W-Floyd/speakeasy/pcb/speakeasy/opti-panel/report.html

# Speakeasy PCB Cost Report

PCB size41.0 × 41.0 mm

AssemblyStandard

Extended parts5

Import duty35.0%

Sales tax9.4%

ShippingDHL Express (DDP)

GeneratedJune 05, 2026

## Summary

Best Price / Board

$13.38 ($14.27)

25 panels × 3x3 · COGS (sale)

Best PCBA Merch Cost / Board

$9.39

25 panels × 3x3

Dominant Cost Bucket

Components

25 panels × 3x3

## COGS per Board — sale price in parens ($/board)

Panels | 1x1 | 2x2 | 2x3 | 3x3
5 | ~$37.12(~$39.05) | $19.20($20.29)✓ | ~$17.43(~$18.41) | $15.89($16.84)✓
10 | $27.27($28.83)✓ | $15.43($16.33)✓ | ~$15.26(~$16.18) | $14.41($15.31)✓
15 | ~$25.43(~$26.87) | ~$15.14(~$16.05) | ~$14.31(~$15.22) | ~$13.99(~$14.88)
20 | ~$23.42(~$24.81) | $14.54($15.45)✓ | ~$14.09(~$14.98) | ~$13.61(~$14.50)
25 | ~$22.22(~$23.57) | ~$14.02(~$14.91) | ~$13.76(~$14.64) | ~$13.38(~$14.27)

Green = lowest COGS in row | White ✓ = verified JLCPCB quote | Grey ~ = model estimate | (parens) = sale price incl. sales tax

## Sale Price per Board vs Panels Ordered

Quantity: Affects breakdown charts and BOM table below

## Cost Breakdown per Board (Stacked)

## Component Cost Breakdown (BOM Pie)

Variant:

## Bill of Materials

LCSC | Description | Qty/bd | Lib Type | Unit Price | $/board
C19702 | 10uF | 1 | Basic | $0.0138 | $0.0230
C15525 | 10uF | 1 | Basic | $0.0175 | $0.0292
C1525 | 100nF | 2 | Basic | $0.0017 | $0.0045
C52923 | 1uF | 1 | Basic | $0.0053 | $0.0088
C64659 | PH-6P立贴 | 1 | Extended | $0.0962 | $0.0962
C20608465 | 210-A-SMD/02 | 1 | Extended | $1.1920 | $1.1920
C25905 | 5.1k | 2 | Basic | $0.0009 | $0.0024
C25744 | 10k | 1 | Basic | $0.0013 | $0.0022
C11702 | 1k | 1 | Basic | $0.0011 | $0.0018
C25741 | 100k | 1 | Basic | $0.0009 | $0.0015
C720477 | BOOT | 2 | Basic | $0.0563 | $0.1276
C22356044 | ESP32-S3-MINI-1U-N4R2 ⚠ Std Only | 1 | Extended | $4.1114 | $4.1114
C910544 | MAX98357AETE+T | 1 | Extended | $1.1630 | $1.1630
C6909495 | MPM3810GQB-33-Z | 1 | Extended | $1.8298 | $1.8298
Components / board | | | | | $8.5934

Extended parts incur an extra fee per order | ⚠ Std Only forces Standard PCBA type

PCBA Merch Cost per Board (excl. duty / shipping)

Panels | 1x1 | 2x2 | 2x3 | 3x3
5 | ~$20.53 | $11.64✓ | ~$10.50 | $10.15✓
10 | $16.68✓ | $9.62✓ | ~$9.83 | $9.67✓
15 | ~$15.39 | ~$9.74 | ~$9.60 | ~$9.51
20 | ~$14.75 | $9.65✓ | ~$9.49 | ~$9.43
25 | ~$14.37 | ~$9.48 | ~$9.42 | ~$9.39

Bare PCBA price from JLCPCB. ~ = estimated from model.

PCB Bare Board Cost per Board (no assembly)

Panels | 1x1 | 2x2 | 2x3 | 3x3
5 | ~$0.97 | ~$0.37 | $0.30✓ | $0.26✓
10 | ~$0.57 | ~$0.27 | ~$0.24 | ~$0.21
15 | ~$0.44 | ~$0.24 | ~$0.21 | ~$0.20
20 | ~$0.37 | ~$0.22 | ~$0.20 | ~$0.19
25 | ~$0.33 | ~$0.21 | ~$0.20 | ~$0.19

Engineering fee $4.00 + $0.1694/board-in-panel × boards × panels. ~ = estimated from model.
