W-Floyd/speakeasy/pcb/speakeasy/speakeasy/jlcpcb/speakeasy_lowcost_jlcpcb_bom.csv

Comment | Designator | Footprint | LCSC Part #
 | U1 | Project:ESP32-S3_SUPER_MINI
