W-Floyd/speakeasy/pcb/speakeasy/speakeasy_lowcost/jlcpcb/speakeasy_lowcost_jlcpcb_bom.csv

Comment | Designator | Footprint | LCSC Part #
 | U1 | Project:ESP32_S3_SUPER_MINI_MODULE
 | U2 | Project:adafruit-MAX98357
