W-Floyd/speakeasy/(list of files, drawings)

Other design files:
snapclient-kconfig/sdkconfig.pcb
