W-Floyd/speakeasy/(commit log)

2026-05-29 fix for bad boards
2026-05-29 Refactor firmware configs into composable packages
    Extract audio and improv config into common/ packages so each
    top-level YAML only declares substitutions and includes; device
    names shortened to remove the redundant 'speakeasy-' prefix.
    [sendspin-audio.yaml]
2026-05-29 Add no-Bluetooth variants for all firmware configs
    Bluetooth disabled variants free up significant heap/IRAM on
    devices where BT is unused.
2026-05-29 Add config generator and pre-commit hook; flatten all variant YAMLs
    cmd/gen-configs generates all 24 speakeasy-*.yaml files from a single
    variant matrix (proto × 2ch × mdns × nobt × ipv6). .githooks/pre-commit
    runs the generator and stages results on every commit.
    Run `git config core.hooksPath .githooks` after cloning to activate.
2026-05-29 Web installer: replace variant list with config selection wizard
    Five questions (protocol, Snapcast server mode, BT, IPv6, output)
    build the manifest path dynamically. Snapcast server question is
    hidden for Sendspin. Shows the variant name and a single Flash
    button; flags unavailable combinations (e.g. 2ch not pre-built).
2026-05-29 Extract WiFi power/ramp into packages; add 4 wifi variants
    base.yaml loses all TX power and ramp config. Four new packages:
    wifi-85.yaml — 8.5 dBm fixed
    wifi-ramp.yaml — stock power + user control + ramp (cap 20.5)
    wifi-85ramp.yaml — 8.5 dBm + user control + ramp (cap 8.5)
    (no package) — stock power, static (new default, no suffix)
    [wifi-ramp.yaml]
2026-05-29 CI/index/wizard: add WiFi dimension (wstock/w85/wramp/w85ramp)
    48 active builds (12 base variants × 4 wifi modes). Web wizard
    gains a WiFi TX Power question with 4 pill options.
2026-05-29 Add variants.yaml as build source of truth
    variants.yaml declares only which variants CI builds (currently 2).
    cmd/gen-ci regenerates .github/workflows/build.yaml from it on commit.
    Docker builds all speakeasy-*.yaml via glob — no list to maintain.
    Dockerfile no longer needs variants.yaml or build.yaml.
2026-05-29 Shorten proto names: sendspin→ss, snapcast→sc
    Keeps hostnames within ESPHome's 24-char limit.
    Labels in the web wizard remain "Sendspin" / "Snapcast".
2026-05-29 Shorten suffixes: -ipv6→-6, w85→w9/w9r, wramp→wr; invert BT to -bt; 9dBm
    Max hostname now 20 chars (well under ESPHome's 24-char limit).
    wifi-85/wifi-85ramp packages replaced by wifi-9/wifi-9ramp at 9.0 dBm.
2026-05-29 Fix duplicate wifi: key in wifi-9ramp.yaml; remove obsolete wifi-85 packages
    [wifi-9ramp.yaml]
2026-05-29 gen-ci: generate Dockerfile with parallel firmware stages
    Each speakeasy-*.yaml gets its own FROM stage with an isolated
    .esphome cache (id=<variant>) and a shared locked PlatformIO cache.
    BuildKit runs all 48 stages in parallel. A collect stage merges
    outputs before the web/server stages.
2026-05-29 Dockerfile: prime PlatformIO in first stage, all others inherit it
    First firmware stage (firmware-sc-6-w9) builds from base, downloading
    the ESP-IDF toolchain into the image layer. All 47 remaining stages
    use FROM firmware-sc-6-w9 so the toolchain is already present with no
    contention. Only the ESPHome build cache stays per-stage.
2026-05-29 Dockerfile: sequential chain, per-stage .esphome cache
    Stages build one after another so ~/.platformio accumulates through
    image layers without re-downloading. Each stage keeps its own
    .esphome cache mount to avoid bloating layers. Collect copies only
    from the final stage which holds all accumulated outputs.
2026-05-29 Isolate toolchain priming from variant yaml changes
    primer.yaml + common/ live in the base stage before speakeasy-*.yaml
    is copied, so changing variant configs doesn't invalidate the primed
    toolchain layer. Cache invalidation chain:
    base (tools+common+primer) → primed (toolchain) → variants (yamls) → builds
2026-05-29 Reorder Dockerfile stages by component set to maximise ccache hits
    gen-configs --dry-run emits filenames in generation order; gen-ci reads
    that instead of globbing so the Dockerfile chain matches. WiFi mode is
    outermost, BT second: all wstock/no-bt compile first, then wstock/bt
    (BLE stack warm), then w9, wr, w9r groups. Ramp lambdas and BLE stack
    each compile once and are reused by all subsequent variants in that group.
2026-05-30 Update default I2S pins: GPIO6/5/4 → GPIO8/9/10
2026-05-30 base: set enable_high_performance: false
    Recommended by snapclient PR #14389 for WiFi devices — helps maintain
    playback after WiFi glitches.
2026-05-31 Generate esp32 variant at top level of each config
    Ensures variant: esp32s3 is set even if common/base.yaml package
    resolution fails during ESPHome dashboard compilation.
2026-06-01 Revert "meh"
    This reverts commit 6076602b22e367b01dca4988bd9ac845172b2725.
    [Speakeasy.kicad_sch, skidl_REPL.kicad_sch]
2026-06-01 1ch again
    [Speakeasy.kicad_sch, speakeasy_jlcpcb_bom.csv]
2026-06-01 panelize variants
    [Speakeasy_panel_2x2-B_Courtyard.gbr, Speakeasy_panel_2x2-B_Cu.gbl, Speakeasy_panel_2x2-B_Mask.gbs, Speakeasy_panel_2x2-B_Paste.gbp, Speakeasy_panel_2x2-B_Silkscreen.gbo, Speakeasy_panel_2x2-Edge_Cuts.gm1, Speakeasy_panel_2x2-F_Courtyard.gbr, Speakeasy_panel_2x2-F_Cu.gtl]
2026-06-05 Add standalone snapclient builds and clean up variant naming
    - Add CarlosDerSeher/snapclient as a git submodule
    - Add cmd/gen-snapclient to generate kconfig defaults for standalone builds
    - Generate snapclient-kconfig/sdkconfig.{mdns,mdns-w9} for ESP32-S3 + MAX98357A
    - Update Dockerfile and CI to build standalone snapclient via espressif/idf:v5.5.1,
    producing a merged binary and manifest.json for esp-web-tools flashing
    - Add standalone snapclient as a protocol choice in the web flash page
    - Remove manual IP snapcast variants (all builds now use mDNS)
    - Drop 'mdns' from variant names since all variants use mDNS
    - Update README: correct DAC (MAX98357A), GPIO pins, and hardware description
    -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
2026-06-05 Add pin mapping table to web flash page
2026-06-05 Register pcb/circuit-synth-local as a submodule
2026-06-05 Track dev branch for circuit-synth-local submodule
2026-06-05 Use HTTPS for circuit-synth-local submodule for CI access
2026-06-05 Only recurse into snapclient submodule in CI
    circuit-synth-local has a broken nested submodule; init it shallowly
    and recurse only into snapclient explicitly.
2026-06-05 Skip circuit-synth-local submodule in CI, init only snapclient
2026-06-05 Fix Stage firmware step to use bash shell
2026-06-05 Improve WiFi TX power UI for standalone snapclient
    - Remove "Sendspin" from timing failure description
    - Hide ramp options when standalone snapclient is selected
    - Drop "no HA control" from 9 dBm label
2026-06-05 Disable light sleep for snapclient to fix Improv USB Serial JTAG
    Light sleep gates USB clocks on ESP32-S3, breaking the USB Serial JTAG
    interface used by Improv WiFi provisioning.
2026-06-05 Enable soft volume control for standalone snapclient
    MAX98357A has no hardware volume register, so Snapcast volume commands
    had no effect. Enable CONFIG_USE_DSP_PROCESSOR and
    CONFIG_SNAPCLIENT_USE_SOFT_VOL so the DSP processor scales PCM samples
    before I2S output.
2026-06-05 Remove ccache mounts from standalone snapclient builds
2026-06-05 Update snapclient: native TX power control; drop mdns-w9 variant
    TX power is now configurable via the general settings web UI (8.5–20 dBm),
    applied at boot and live on change, persisted to NVS — replacing the
    separate kconfig-based mdns-w9 build variant.
    Also syncs sdkconfig.mdns with the Sendspin kconfig baseline: adds missing
    SPIRAM init/malloc opts, WiFi TX buffer settings, compiler perf opt,
    FreeRTOS IRAM/tick opts, WiFi IRAM opts (beneficial on quad PSRAM S3),
    AMPDU windows, disconnected PM disable, LwIP tuning, and log level opts.
2026-06-06 Update snapclient: track develop branch; overlay cleanup; enable TX power + vol curve
    - Submodule now tracks W-Floyd/snapclient develop branch
    - sdkconfig overlay restructured: removes upstream duplicates, comments out
    non-essential tuning for incremental validation
    - Enables CONFIG_SNAPCLIENT_WIFI_TX_POWER_CONTROL (native to develop branch)
    - Sets CONFIG_SNAPCLIENT_VOLUME_CURVE_DB_RANGE=40 (was 60)
2026-06-07 Remove WiFi TX power axis; add snapclient OTA binary to builds and index
    ESPHome variants now always include common/wifi-ramp.yaml (stock power +
    HA ramp control on drop), eliminating the w9/wr/w9r axis. Reduces variant
    count from 16 to 4 (ss, sc, ss-bt, sc-bt).
    Snapclient builds now produce a snapclient-<variant>-ota.bin alongside
    merged.bin, included in Docker, CI artifacts, and the web installer as a
    download link. Index page details the web OTA feature in the changes section.
    Also adds scripts/ota-flash-snapclient.sh for extracting from the Docker
    image and flashing over the network, with pre/post SHA256 verification via
    /api/ota/status and TCP port 8032 fallback for old firmware.
    Co-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
2026-06-08 snapclient: update submodule to aa127dd; enable DSP soft clip
    Submodule changes:
    - Fix WiFi TX power unit labels (raw ESP-IDF units, not dBm)
    - Apply channel mode immediately without restart
    - Rate-limit RESYNCING HARD log spam to once per second
    - Remove udp_logger integration (keep component files)
    sdkconfig changes (gen-snapclient and sdkconfig.mdns):
    - Enable CONFIG_USE_DSP_SOFT_CLIP
2026-06-08 snapclient: update submodule to 4859f59
    - Add Mono channel mode (mix L+R to both outputs)
    - Add manifest-based pull OTA: device fetches manifest URL, version-checks,
    downloads and flashes binary with SHA-256 integrity verification
    - Fix pull OTA: HTTPS TLS verification, manifest URL encoding (POST+JSON),
    body_len redefinition, httpd stack overflow, app_desc offset (40→48)
    - Add MBEDTLS_CERTIFICATE_BUNDLE dependency for HTTPS OTA
2026-06-08 index: update changelog; show OTA manifest URL for pull OTA
    - Channel routing: add Mono to the description
    - Split Web OTA into push and pull entries
    - Show pull OTA manifest URL below the flash area when available,
    with a note that already-flashed devices can use it directly
    - gen-index: scan for ota-manifest.json per variant and expose to JS
2026-06-08 index: make OTA manifest URL copy-pasteable
    Replace <code> with a read-only input + Copy button that writes to
    clipboard and briefly shows "Copied!" confirmation.
2026-06-08 snapclient: extract app_elf_sha256 from binary for OTA manifest
    The manifest sha256 field now matches what the device reports via
    esp_app_desc_t.app_elf_sha256 (scanned by magic word 0xABCD5432,
    read at struct offset +144). Adds file_sha256 for the full-file hash.
2026-06-09 snapclient: embed idf_size.py memory report in index page
    Runs idf_size.py --format json after each snapclient build and stores
    size.json alongside the firmware. gen-index reads it and embeds the
    data as a JS object; the index page shows a collapsible DIRAM/flash
    breakdown per variant and displays live deltas on the Pull OTA option
    cards (only on the unselected card, relative to current selection).
2026-06-09 snapclient: set version from speakeasy git hash, extract from binary for manifest
    Writes version.txt (speakeasy short hash) before build so PROJECT_VER
    picks it up as the firmware version string. sc_ver in ota-manifest is
    then extracted from desc->version in the compiled binary, ensuring the
    manifest version always matches what the device reports.
    Also fixes broken Go string (unescaped quotes) and use find→split for
    null-terminated string extraction.
2026-06-09 ci: source IDF env in Stage firmware step so esptool is available
    python3 -m esptool requires the IDF virtualenv; without sourcing
    export.sh the system Python is used which doesn't have esptool installed.
2026-06-09 ci: ignore exit code 2 from IDF export.sh
    export.sh exits with 2 even on success; with set -e active this killed
    the Stage firmware step before any work ran.
2026-06-09 ci: move ota-manifest to Build step; call esptool by name everywhere
    - ota-manifest.json generation moved into Build step where the IDF env
    is already active; Stage firmware just copies it as an artifact
    - Use esptool.py (IDF env) and esptool (homebrew) by name instead of
    python3 -m esptool
2026-06-09 dockerfile: copy go.sum and download deps before building gen-index
    go mod download needs network access and go.sum for verification;
    also copy docs/ into the web stage so gen-index can embed them.
2026-06-09 docs: add dupont jumper wires to low-cost parts list
2026-06-09 docs: update low-cost parts list and wiring table
2026-06-09 docs: add price column, USB power supply, and total to parts table
2026-08-08 Add PCB hardware variant alongside off-the-shelf builds
    Firmware variants gain a hardware dimension. What was previously implicit
    in "ESP32-S3 Supermini" is now explicitly `ots`, and a parallel `pcb`
    target for the custom Speakeasy board (ESP32-S3-MINI-1U-N4R2) is built
    alongside it. ESPHome variants go 4 -> 8, snapclient sdkconfigs 2 -> 4.
    Hardware targets:
    ots LRCLK/BCLK/DOUT on GPIO 4/5/6 -- ESP32-S3 Supermini, hand-wired or
    on the Speakeasy Lowcost PCB
    pcb DOUT/BCLK/LRCLK on GPIO 4/5/6 -- custom Speakeasy board
    Both boards use the same three pins with LRCLK and DOUT transposed, so
    they are not firmware-interchangeable. This retargets `ots` from its
    former GPIO 10/11/12 pin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
    [Speakeasy Lowcost-B_Courtyard.gbr, Speakeasy Lowcost-B_Cu.gbl, Speakeasy Lowcost-B_Mask.gbs, Speakeasy Lowcost-B_Paste.gbp, Speakeasy Lowcost-B_Silkscreen.gbo, Speakeasy Lowcost-Edge_Cuts.gm1, Speakeasy Lowcost-F_Courtyard.gbr, Speakeasy Lowcost-F_Cu.gtl]
